Peemouse/Martin-Magnum-DMX-controller/Martin official docs/Martin mag 1200 remote control.pdf

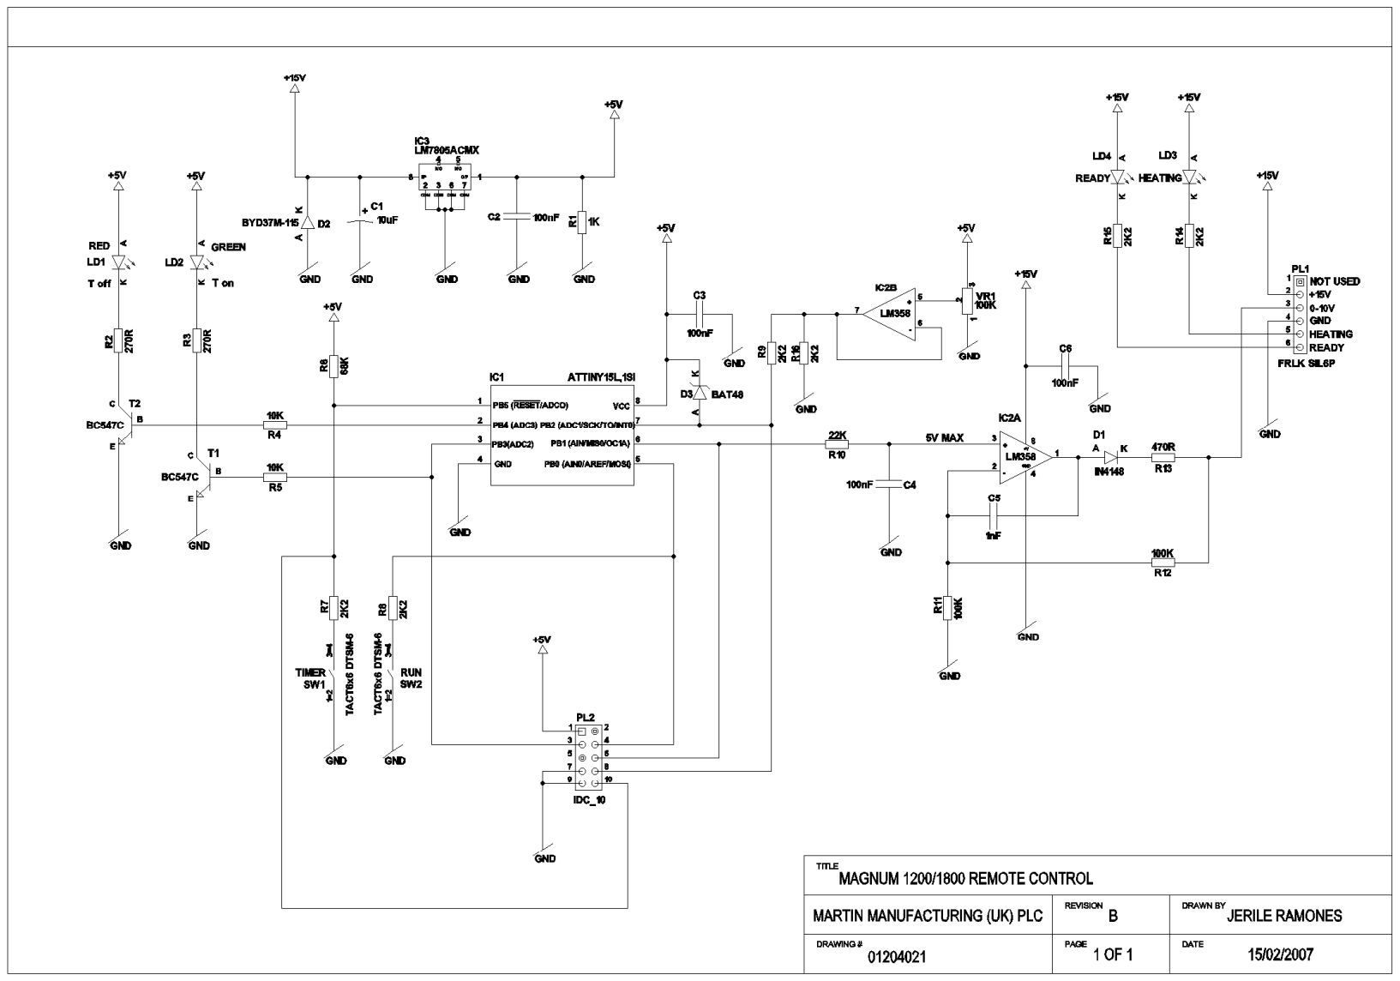
[picture p1: page 1]
