Peemouse/Martin-Magnum-DMX-controller/Martin official docs/Martin mag 850 remote control single button.pdf

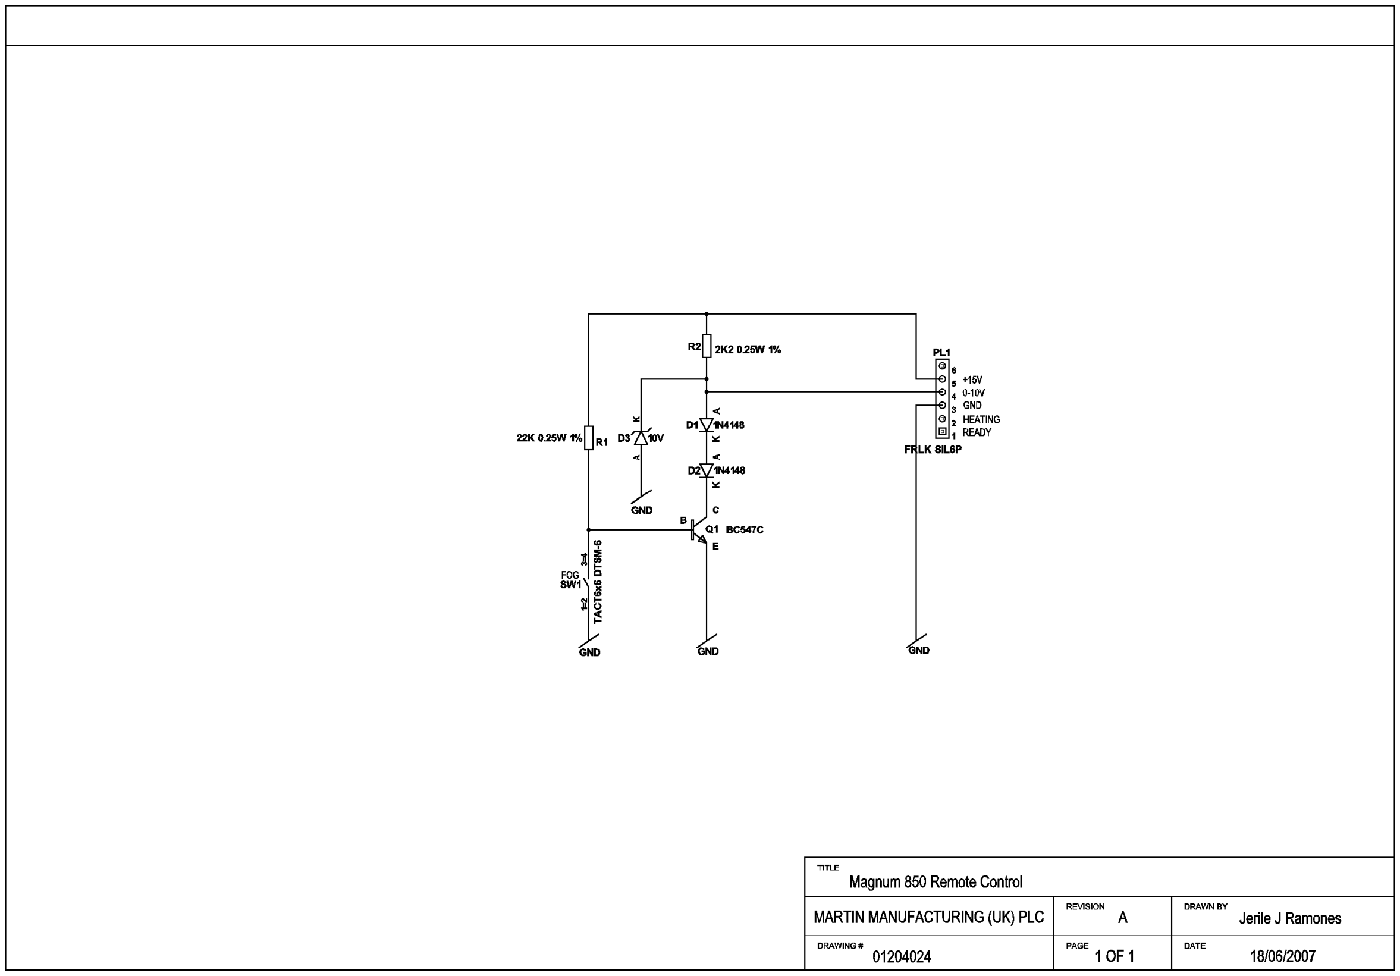
[picture p2: page 1]
