Peemouse/Martin-Magnum-DMX-controller/Martin official docs/RJ45 remote control interface internal board.pdf

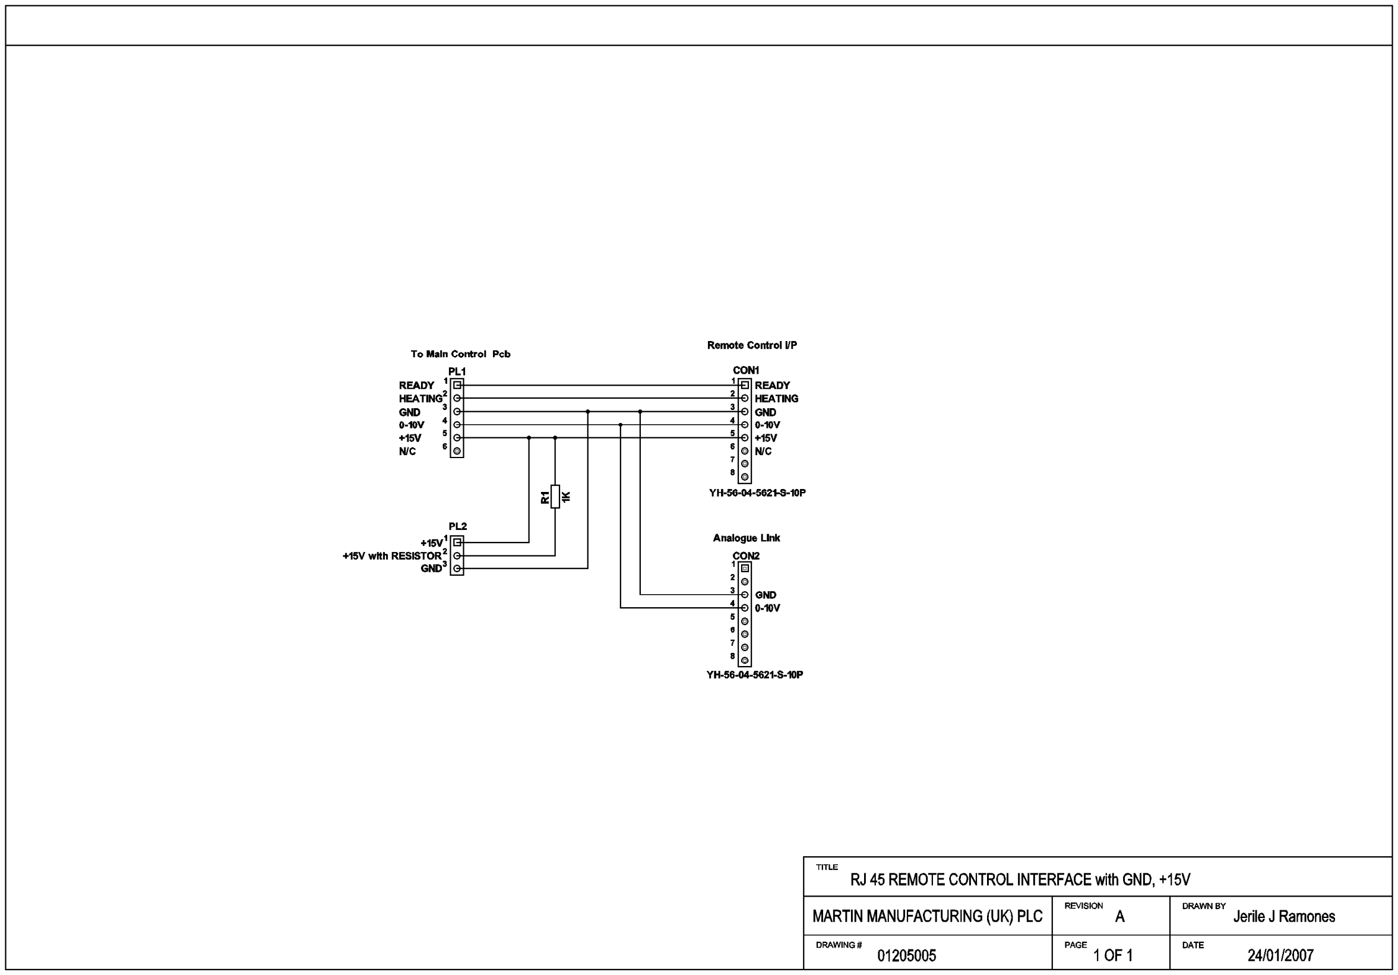
[picture p3: page 1]
