Peemouse/Martin-Magnum-DMX-controller/(commit log)

2026-02-15 First working FW
    Connectivity : only wired DMX is working, no Ethernet connection yet.
2026-05-04 v0.1 Stable version with fan control option
2026-05-06 Add BOM to Readme
